frankB415/easun6048_display_sniffer/IMG_20250204_103244.jpg

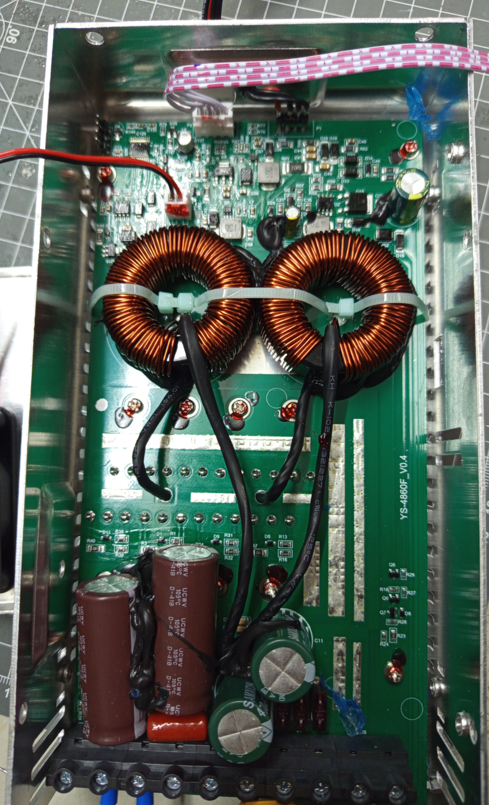
IMG_20250204_103244.jpg
